Wangxiao616/Auto_sail/Changelog.md

# CHANGELOG

4.13
1.在CubeMX中将编译工具改为CMake
2.在根目录中的CMakeLists.txt中添加了User目录的编译选项

只能在根目录中的CMakeLists.txt中添加内容，否则会被覆盖
4.14
1.在CMakelists中修改project_name为AUTO_SAIL_3,修复了project不能被找到的问题
2.测试时需要调试 SG90_INIT_ANGLE 使舵机初始角度居中
3.修改红外逻辑

加权逻辑：7个红外管按位置赋权重，被触发的红外管累加出权重和，权重和通过系数5映射到角度偏移，再加到基础 角度（150°）上，得到目标舵机角度,然后状态归零，实现循环

（1）注意，红外管是呈圆环排列的，5在正前方，2在正右方，8在正左方
（2）文件结构：在User目录下新增了Infrared目录，用于存放红外传感器相关的代码
（3）在sg90.c中新增了角度映射函数 int SG90_CalcTargetAngle(int8_t weight_sum) 同时在sg90.h中声明
（4）在main.c引入了sg90.h头文件，修改了中断回调函数 void HAL_GPIO_EXTI_Callback(uint16_t GPIO_Pin)
    其中：
    /1.加入了防抖延时和验证（或许可以应对学长提出的手机红外信号为调制信号，会有多个脉冲信号从而触发多个中断的问题）
    /2.记录传感器触发状态
（5）在main.c中新增红外初始化 Infrared_Init();
（6）在while循环中新增红外加权计算目标角度的逻辑
（7）在CMakeLists.txt中新增了Infrared目录的编译选项
（8）需要根据具体测试情况调整的参数：各红外管的权重（船如果偏左就减小左侧红外管权重），权重系数（船如果变相太灵敏就减小）
(9)新增串口调试功能：
    /1.在main.c中新增串口调试相关宏和头文件
    /2.在中断函数中新增串口调试语句
    /3.在while循环中新增串口打印
    /4.最终输出效果：
        IR_TRIG: IRM8
        WEIGHT: -3 | ANGLE: 135 | IR_STAT: [000000010]
        IR_TRIG: IRM2
        WEIGHT: 3 | ANGLE: 165 | IR_STAT: [010000000]
4.16
1.在Infrared.h中更正了红外管加权参数，测试时仍需根据实际转向情况调整
2.红外管1和9权重设为零，否则船的转向可能被后面的红外信号影响
3.把文件包丢给cursor勘误后修改了CMakelists中User目录的编译选项
4.删除了main.c中没有被用到的duty变量
5.优化了中断函数中的防抖和串口打印逻辑
/1.用时间戳取代DELAY函数，在main.c中新增了一个宏定义和三个变量：
    #define IR_DEBOUNCE_MS 15U // 防抖时间（毫秒）用于中断回调函数
    static uint32_t ir_last_tick[IR_SENSOR_NUM] = {0};
    volatile uint8_t ir_dbg_pending = 0;
    volatile uint8_t ir_dbg_idx = 0xFF;
/2.把串口打印事件挪到while循环中，避免在中断中打印，导致串口阻塞，只在中断中留下串口打印标志  ir_dbg_idx = idx;
                    ir_dbg_pending = 1;
/3.更新了主循环中的串口打印逻辑，且用时间戳确保每100ms输出一次，避免刷屏阻塞
6.学长原本位于sg90.h中的setduty函数存在逻辑问题：当目标方向与当前方向相同时则无更新，可能会导致转向延迟且不灵敏，做了以下优化：
/1.更新了__SG90_SetDuty函数，用步进更新逻辑取代原本的逻辑判断，同样能达成时舵机角度变化平滑的效果

4.20
1.调试直接在左侧栏点运行和调试选择stlink选项就可以
2.调试了电机模块，电机运作正常，需注意电机驱动板有两根额外的线要接，一根要和系统板共地，一根要从驱动板的STBY接口接到电源拓展模块的正极（给它一个高电平，否则电机会休眠）
3.调试了舵机模块，舵机运作正常，删除了之前新增的步进逻辑，因为实际测试中表现不好
4.调零了舵机，将归中角度暂时设为90度（需根据实际情况调整）
5.考虑之后是否增加转弯时电机减速的逻辑
6.调试了串口模块，需注意串口RX和TX引脚要和系统板上的反接，并且要和系统板共地，删除了学长之前的串口发送代码并调试了自己的串口发送代码并验证可用（串口助手用的SSCOM）
7.在while循环中有注释掉的各部件调试代码，可复用
8.调试了红外传感器模块，因为手机红外信号为调制信号且为瞬时信号（比赛是连续的），同时室内有严重的信号反射问题，没办法正常验证红外转向逻辑的运行（串口显示无论从哪个角度发射信号，所有红外管都触发）
9.最后采用了掩码验证了各个红外传感器正常运作，且验证了仅单个红外传感器运作时，红外加权和转向的逻辑运行是正常的。
10.注意到时候下水测试之前要注释掉掩码部分，在main.c中的数组定义和中断函数中
11.计划自己组建红外发射器然后下水测试
6.4
1.突然意识到传感器1和9在后方的问题，通过掩码关闭了这两个传感器（去查看了一下权重设置，这两个传感器权重为零，但是为了稳定性考虑还是关掉吧）

6.6
1.新增GME12864-49 OLED显示屏驱动（I2C接口，4引脚），用于在船运行时实时显示红外传感器触发状态
  /1.新建User/OLED目录，包含以下文件：
      - oled.h：OLED驱动API声明（初始化、清屏、画点、显示字符/字符串、刷新）
      - oledfont.h：6x8和8x16 ASCII字库（95个可打印字符）
      - oled.c：SSD1306驱动实现（地址0x3C，GRAM缓冲128x64，页刷新模式）
        采用软件模拟I2C（PB14=SCL, PB15=SDA, 推挽输出+内部上拉），
        不占用硬件I2C外设，GPIO在OLED_Init()内自行初始化，无需CubeMX额外配置
  /2.在CMakeLists.txt中新增User/OLED/Src/*.c和User/OLED/Inc编译路径
  /3.修改main.c：
      - 引入oled.h头文件
      - 在初始化段调用OLED_Init()
      - 在while循环中新增OLED显示逻辑：每200ms刷新，显示被触发的红外传感器编号、
        权重和、目标角度；触发状态保持500ms后自动清除；无触发时显示"All Clear"
  /4.硬件连接：OLED仅4引脚（GND→GND, VDD→3.3V, SCK→PB14, SDA→PB15），
      直连即可，无需电平转换
  /5.注意：CubeMX中禁用I2C2（原PB10被占用），OLED的SCL/SDA由oled.c自行初始化为GPIO Output

6.10
1.重构红外加权逻辑：从原始加权累加改为"邻居确认+同侧确认"策略，以应对比赛场地严重的红外反射问题

  问题背景：
  - 红外传感器用于检测光电门方向（非避障），传感器呈圆环排列：5正前、2正右、8正左
  - 比赛场地水面/墙壁反射严重，导致对侧传感器被误触发
  - 原方案所有触发传感器权重直接累加，反射导致正负权重相互抵消甚至反转转向方向
  - 例：门在右侧，IRM_3(+3)、IRM_4(+2)被直射触发，IRM_7(-3)、IRM_8(-4)被反射误触发
        权重和 = (+3+2)+(-3-4) = -2 → 船向左转，背离正确的门

  新策略设计思路：
  核心假设：光电门为点状红外源，直射信号触发2~3个相邻传感器形成连续弧段；
           反射信号通常是散乱的孤立触发，无邻居伴随且难以集中在同侧

  确认规则（满足任一即视为真信号）：
  (1) 仅1个传感器触发 → 直接信任（弱信号不丢弃，无对侧抵消风险）
  (2) 物理邻居也触发 → 确认（邻接传感器形成连续弧段，符合点源特征）
  (3) 同侧有≥2个触发 → 确认（不邻接但在同侧，方向一致，如IRM_2和IRM_4同时触发）

  三条都不满足 → 判定为反射，丢弃

  具体改动：
  /1. infrared.h 新增邻居查找表 ir_neighbor_left[] 和 ir_neighbor_right[]
      编码圆环上每个传感器的左右邻居索引（含首尾循环）
  /2. infrared.c 重写 Infrared_CalcWeightSum()
      统计触发总数及左右侧触发数 → 单触发走原始逻辑 → 多触发按三条规则确认
  /3. main.c 无需修改，接口不变

  典型场景推演：
  - IRM_3,4触发(邻接) + IRM_7(孤立反射) → 3,4邻接确认，7丢弃 → 正确右转
  - IRM_2,4触发(同侧不邻接) → 同侧确认 → 正确右转
  - IRM_3(真) + IRM_7(反射) → 两侧各1不够同侧阈值，均无邻居 → 全部丢弃 → 直行（安全默认）
  - 仅IRM_3触发(远距离弱信号) → 触发数=1，直接信任 → 正确右转

2.代码审查与清理
  /1. 删除死代码：main.c中 float angle、int fstFlag；sg90.c中 char message[20]、uint32_t defaultCMP
  /2. 修复 #include 风格：infrared.h和oledfont.h中 "stdint.h"→<stdint.h>，main.c中 "stdio.h"→<stdio.h>
  /3. 修复IRM_5同侧计数缺陷：权重=0的传感器（IRM_5正前方）触发时计入左右两侧计数
      解决了IRM_5+IRM_3同时触发时right_count=1导致IRM_3被丢弃的问题
      （IRM_5不邻接IRM_3，且原逻辑中权重=0不计入任一侧，导致唯一的方向传感器无法通过同侧确认）

6.11
1.代码清理与修复
  /1. 删除死代码：main.c中 float angle、int fstFlag；sg90.c中 char message[20]、uint32_t defaultCMP
  /2. 修复 #include 风格：infrared.h和oledfont.h中 "stdint.h"→<stdint.h>，main.c中 "stdio.h"→<stdio.h>

2.舵机转向方向修复
  问题：下水测试发现站在船左侧发射红外信号，船向右转（背离信号源）
  原因：舵机物理行为是低角度=右转、高角度=左转，但代码假设相反
       左侧传感器(IRM_6,7,8)触发 → 负权重和 → 角度减小 → 代码以为左转 → 实际右转
  修复：sg90.c中 SG90_CalcTargetAngle 的权重系数从 +5 翻转为 (-5)
       左侧触发 → 负权重×(负系数)=正偏移 → 角度增大 → 物理左转 ✓
       右侧触发 → 正权重×(负系数)=负偏移 → 角度减小 → 物理右转 ✓
  调参：实测-5转向略不足，系数经-6最终调整为-7

3.OLED显示格式重构
  问题：旧格式用8x16大字号+32像素列宽，128宽屏幕最多显示4个传感器编号
  改进：
    - 顶部新增9传感器状态条（每个12x10方块，实心=触发/空心=未触发，总宽126px）
    - 触发的传感器编号改用6x8小字，一行最多显示21字符，可容下全部9个传感器
    - 底行权重和角度也改用6x8字体

4.红外抗反射策略探索（未采用，保留原始加权逻辑）
  评估了邻居确认、方向优势两种抗反射策略，进行了39个场景推演验证
  方向优势策略在2真vs2反射场景下存在平局→直行的保守行为
  综合判断：原始加权逻辑配合正确的舵机方向系数已可满足当前需求，实际到场地下水测试发现反射情况没有太大影响，所以暂不更新红外逻辑

---

## 7.1 — `红外逻辑反射抗性分支`

### 新增

- **针对强反射情景的逻辑**：时间驱动的交替传感器遮蔽机制，应对水池壁红外反射干扰
  - `IR_MaskSide` 枚举（IR_MASK_NONE / IR_MASK_LEFT / IR_MASK_RIGHT）
  - `Infrared_SetMaskSide()` / `Infrared_GetMaskSide()` / `Infrared_IsSensorMasked()` API
  - 三层防护：中断层过滤 → 状态设置层检查 → 加权计算层过滤

### 修改

- [infrared.h](User/Infrared/Inc/infrared.h)：新增遮蔽模式枚举和 API 声明
- [infrared.c](User/Infrared/Src/infrared.c)：实现遮蔽判断逻辑，加权和计算跳过被遮蔽传感器
- [main.c](Core/Src/main.c)：
  - 新增可调参数 `MASK_PHASE_MS`（单侧遮蔽时长，默认 8000ms）、`MASK_UNMASK_GAP_MS`（间隙时长，默认 2000ms）和 `MASK_FIRST_RIGHT`（首遮蔽侧，默认 1=右侧）
  - EXTI 回调中增加遮蔽过滤
  - 主循环增加基于 Cycle 的交替遮蔽 + 不遮蔽间隙逻辑
  - OLED 底行显示 Cycle 编号和遮蔽状态（ML/MR/--）

### 文档

- [README.md](README.md)：新增"针对强反射情景的逻辑"章节
