Wangxiao616/Auto_sail/Core/Inc/main.h

#define LED_Pin GPIO_PIN_13
#define LED_GPIO_Port GPIOC
#define SG90_Pin GPIO_PIN_1
#define SG90_GPIO_Port GPIOA
#define IRM_1_Pin GPIO_PIN_4
#define IRM_1_GPIO_Port GPIOA
#define IRM_1_EXTI_IRQn EXTI4_IRQn
#define IRM_2_Pin GPIO_PIN_5
#define IRM_2_GPIO_Port GPIOA
#define IRM_2_EXTI_IRQn EXTI9_5_IRQn
#define IRM_3_Pin GPIO_PIN_6
#define IRM_3_GPIO_Port GPIOA
#define IRM_3_EXTI_IRQn EXTI9_5_IRQn
#define IRM_4_Pin GPIO_PIN_7
#define IRM_4_GPIO_Port GPIOA
#define IRM_4_EXTI_IRQn EXTI9_5_IRQn
#define IRM_5_Pin GPIO_PIN_8
#define IRM_5_GPIO_Port GPIOA
#define IRM_5_EXTI_IRQn EXTI9_5_IRQn
#define IRM_6_Pin GPIO_PIN_9
#define IRM_6_GPIO_Port GPIOA
#define IRM_6_EXTI_IRQn EXTI9_5_IRQn
#define IRM_7_Pin GPIO_PIN_10
#define IRM_7_GPIO_Port GPIOA
#define IRM_7_EXTI_IRQn EXTI15_10_IRQn
#define IRM_8_Pin GPIO_PIN_11
#define IRM_8_GPIO_Port GPIOA
#define IRM_8_EXTI_IRQn EXTI15_10_IRQn
#define IRM_9_Pin GPIO_PIN_12
#define IRM_9_GPIO_Port GPIOA
#define IRM_9_EXTI_IRQn EXTI15_10_IRQn
#define DRV8833_IN1_Pin GPIO_PIN_6
#define DRV8833_IN1_GPIO_Port GPIOB
#define DRV8833_IN2_Pin GPIO_PIN_7
#define DRV8833_IN2_GPIO_Port GPIOB
