Wangxiao616/Auto_sail/User/OLED/Inc/oledfont.h

#ifndef OLEDFONT_H
#define OLEDFONT_H

#include <stdint.h>

/* 6×8 字体 — ASCII 0x20~0x7E 共 95 个字符 */
static const uint8_t F6x8[][6] = {
    {0x00,0x00,0x00,0x00,0x00,0x00}, /* space */
    {0x00,0x00,0x5F,0x00,0x00,0x00}, /* ! */
    {0x00,0x07,0x00,0x07,0x00,0x00}, /* " */
    {0x14,0x7F,0x14,0x7F,0x14,0x00}, /* # */
    {0x24,0x2A,0x7F,0x2A,0x12,0x00}, /* $ */
    {0x23,0x13,0x08,0x64,0x62,0x00}, /* % */
    {0x36,0x49,0x55,0x22,0x50,0x00}, /* & */
    {0x00,0x05,0x03,0x00,0x00,0x00}, /* ' */
    {0x00,0x1C,0x22,0x41,0x00,0x00}, /* ( */
    {0x00,0x41,0x22,0x1C,0x00,0x00}, /* ) */
    {0x08,0x2A,0x1C,0x2A,0x08,0x00}, /* * */
    {0x08,0x08,0x3E,0x08,0x08,0x00}, /* + */
    {0x00,0x50,0x30,0x00,0x00,0x00}, /* , */
    {0x08,0x08,0x08,0x08,0x08,0x00}, /* - */
    {0x00,0x60,0x60,0x00,0x00,0x00}, /* . */
    {0x20,0x10,0x08,0x04,0x02,0x00}, /* / */
    {0x3E,0x51,0x49,0x45,0x3E,0x00}, /* 0 */
    {0x00,0x42,0x7F,0x40,0x00,0x00}, /* 1 */
    {0x42,0x61,0x51,0x49,0x46,0x00}, /* 2 */
    {0x21,0x41,0x45,0x4B,0x31,0x00}, /* 3 */
    {0x18,0x14,0x12,0x7F,0x10,0x00}, /* 4 */
    {0x27,0x45,0x45,0x45,0x39,0x00}, /* 5 */
    {0x3C,0x4A,0x49,0x49,0x30,0x00}, /* 6 */
    {0x01,0x71,0x09,0x05,0x03,0x00}, /* 7 */
    {0x36,0x49,0x49,0x49,0x36,0x00}, /* 8 */
    {0x06,0x49,0x49,0x29,0x1E,0x00}, /* 9 */
    {0x00,0x36,0x36,0x00,0x00,0x00}, /* : */
    {0x00,0x56,0x36,0x00,0x00,0x00}, /* ; */
    {0x00,0x08,0x14,0x22,0x41,0x00}, /* < */
    {0x14,0x14,0x14,0x14,0x14,0x00}, /* = */
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
    {0x08,0xF8,0x88,0x88,0x88,0x08,0x00,0x00,0x10,0x1F,0x10,0x00,0x00,0x00,0x00,0x00}, /* F */
    {0x00,0xF0,0x08,0x08,0x08,0x10,0x00,0x00,0x00,0x07,0x08,0x08,0x09,0x07,0x00,0x00}, /* G */
    {0x08,0xF8,0x88,0x80,0x80,0x88,0xF8,0x08,0x10,0x1F,0x10,0x00,0x00,0x10,0x1F,0x10}, /* H */
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
};

#endif
