Wangxiao616/Auto_sail/(commit log)

2026-06-14 初始提交，项目初始化
2026-06-14 测试远程仓库的提交
2026-06-15 修改gitignore
2026-06-15 更新了README
2026-07-01 添加gitignore忽略编译目录
2026-07-01 更新了README和changelog
2026-07-01 从反射抗性分支的提交d6145c753279a5d701a7effd920f77bbc8ab2454中提取更新的README和Changelog文件
